Arasaka-Academy/CyberMachine/docs/images/r1/exploded.png

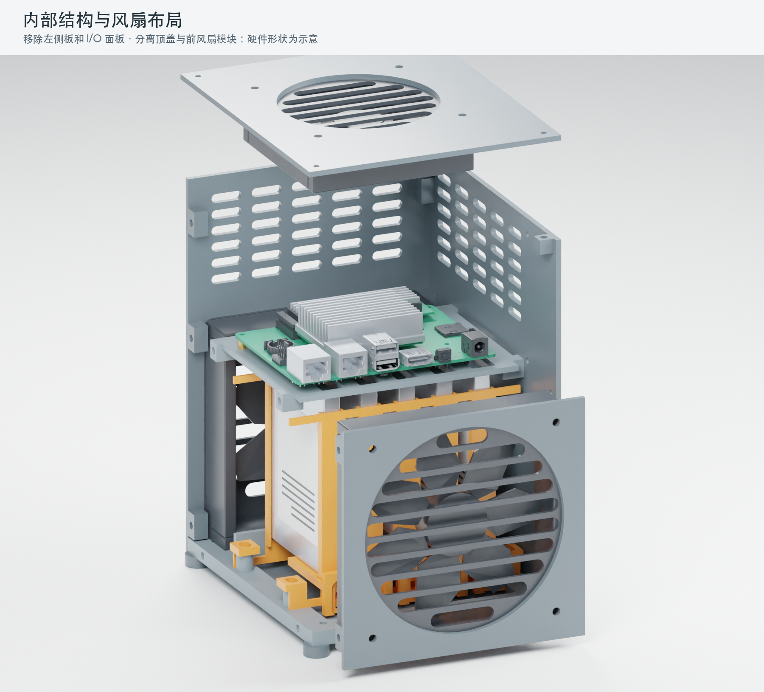
docs/images/r1/exploded.png
