Arasaka-Academy/CyberMachine/docs/images/r2/7mm-shims.png

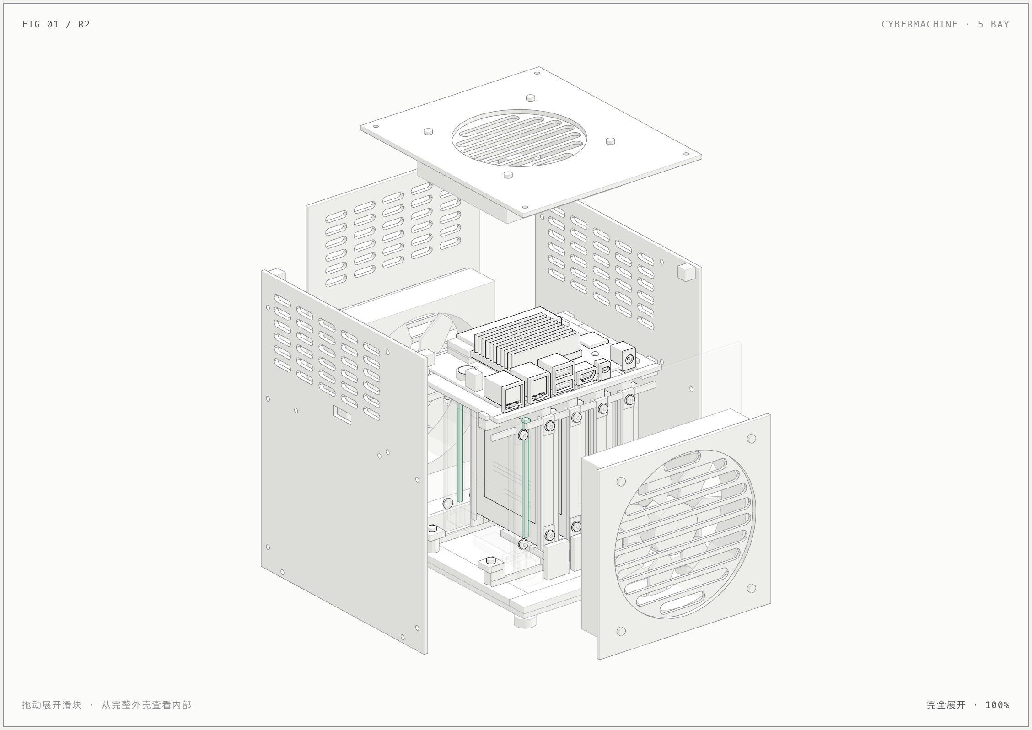
docs/images/r2/7mm-shims.png
