Arasaka-Academy/CyberMachine/hardware/enclosure/r1/cad/CyberMachine-r1-enclosure.step

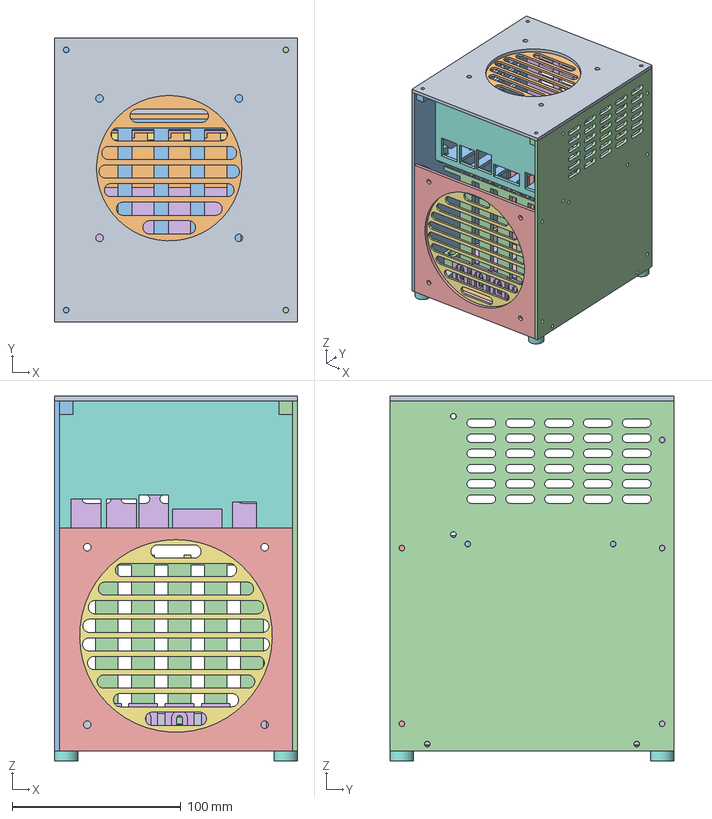
[picture p4: CAD file, 2026-11-03]
hardware/enclosure/r1/cad/CyberMachine-r1-enclosure.step
144.0 x 168.0 x 216.0 mm
