Arasaka-Academy/CyberMachine/hardware/enclosure/r1/print/CyberMachine-r1-fit-test-p1s.3mf

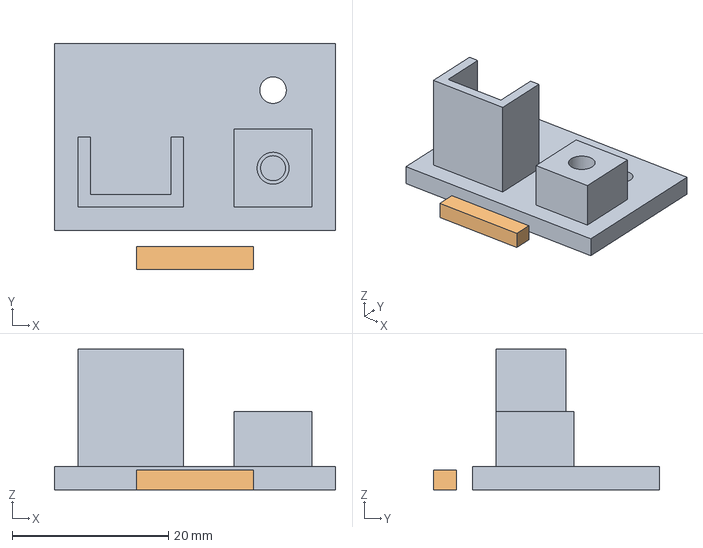
[picture p5: CAD file, 2026-11-03]
hardware/enclosure/r1/print/CyberMachine-r1-fit-test-p1s.3mf
36.0 x 29.0 x 18.0 mm
00_fit_coupon_1
00_fit_shim_2p5_1
