Arasaka-Academy/CyberMachine/references/radxa-taco/radxa_taco_3d_stp_v1.61.stp

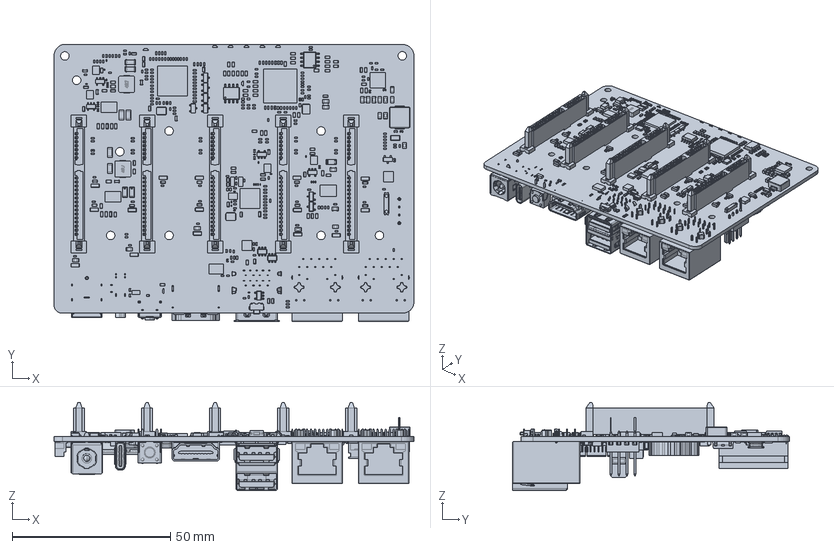
[picture p6: CAD file, 2026-11-03]
references/radxa-taco/radxa_taco_3d_stp_v1.61.stp
113.7 x 87.5 x 27.8 mm
TACO-V161_20250806
C0201 x 28
QFN76_9X9
R0402 x 203
C0402 x 174
C0805 x 38
C0603 x 70
C1206 x 9
R1206 x 3
SMD-LED-0603
LED0603 x 6
SOD523 x 2
R0805 x 7
L0603 x 21
WCM2012F x 3
0518_55X55 x 2
IND-6X6
IND-2520 x 4
IND-5020 x 4
IND_252012
SOT-23 x 5
SOT723 x 2
SOT23 x 4
R0201 x 24
R0603 x 57
T0_8
SOP8 x 3
SOT_23_5 x 4
8_LEAD_SOP x 2
SON10_2R50X1R00X0R50 x 6
EEPROM_TSSOP_8
MSOP_8 x 2
SCT2360 x 3
SLP2510P8 x 2
SOT23-8
QFN48_6X6
SOT23-6 x 2
TO252_H94
QFN_19P_20_157X157_2PAD
QFN_88P_16_394X394_PAD_ATH
CRY-D3225 x 3
CRY-MC146
SOIC8E
ESD0402 x 4
LED_MT-L1204RGBC-B3-SESESERB1
SMD-2P-1_25
SOD_123
SOT_23_5AA
SOT_323
AON7407
SW_4_DIP
TS_1100_5
APCI0164_4
APCI0108_200415_ASM_4
HDMI_1_2_4
LPJG0926HENL_4 x 2
DC-091-A200_1__4
MSBR-1_1_2_1_5_1_4
TF-CARD_1_2_1_5_1_4 x 2
LOWER_CONTACT_4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
