Arasaka-Academy/CyberMachine/hardware/enclosure/r1/print/CyberMachine-r1-5bay-p1s-petg.3mf

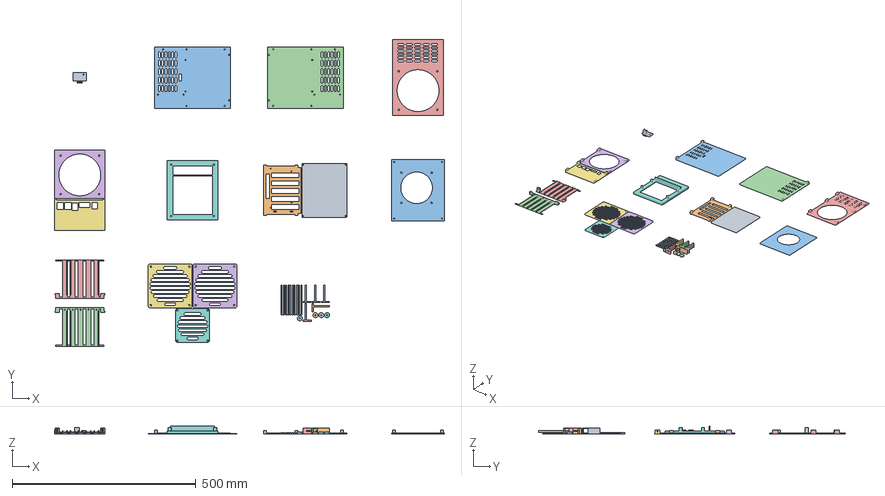
[picture p7: CAD file, 2026-11-03]
hardware/enclosure/r1/print/CyberMachine-r1-5bay-p1s-petg.3mf
1062.6 x 835.9 x 22.0 mm
00_fit_coupon_1
00_fit_shim_2p5_1
03_left_side_1
04_right_side_1
06_rear_fan_panel_1
05_front_fan_panel_1
09_recessed_IO_panel_1
01_base_frame_1
02_service_hatch_1
12_motherboard_saddle_1
10_top_lid_1
13_front_drive_guide_1
14_rear_drive_guide_1
07_front_guard_1
08_rear_guard_1
11_top_guard_1
15_drive_shoe_1_1
16_7mm_shim_1_front_1
16_7mm_shim_1_rear_1
15_drive_shoe_2_1
16_7mm_shim_2_front_1
16_7mm_shim_2_rear_1
15_drive_shoe_3_1
16_7mm_shim_3_front_1
16_7mm_shim_3_rear_1
15_drive_shoe_4_1
16_7mm_shim_4_front_1
16_7mm_shim_4_rear_1
15_drive_shoe_5_1
16_7mm_shim_5_front_1
16_7mm_shim_5_rear_1
17_foot_1_1
17_foot_2_1
17_foot_3_1
17_foot_4_1
