Arasaka-Academy/CyberMachine/docs/assembly/r1.md

# CyberMachine 五盘 NAS 外壳 · R1

CyberMachine NAS 设备的 R1 机箱设计，适配 Radxa Taco V1.61、5 块 2.5 英寸 SATA 硬盘（7 或 9.5 mm），前后 12025 风扇及顶部 9225 风扇。机箱主体 144 × 168 × 210 mm，脚垫另加 6 mm。原设计日期：2026-10-30。

## 先打印什么

先打开 **CyberMachine-r1-fit-test-p1s.3mf**，使用准备正式打印的 PETG 打印试装件。其 U 槽与正式导轨一致：净宽 10.3 mm；装入 2.5 mm 垫片后净宽为 7.8 mm。用实际硬盘边缘检查滑动配合，同时试装 M3 铜螺母和通孔。应能顺畅滑动，不能靠挤压硬盘来消除间隙。

确认后打开 **CyberMachine-r1-5bay-p1s-petg.3mf**，选择“作为项目打开”，保留项目配置。已配置 Bambu Lab P1S、0.4 mm 喷嘴、PETG、纹理 PEI 板、0.20 mm 层高、4 层壁、25% Gyroid 填充。五个独立托脚采用 100% 填充。通用 PETG 设定为喷嘴 255°C、热床 80°C；按实际耗材厂商建议调整温度后重新切片。

这是 Bambu Studio 多盘项目，包含切片结果。用 Bambu Studio 选择对应打印盘发送到 P1S；不要把整套装配 STEP 当作单个零件切片。

## 打印盘与零件

| 盘 | 内容 | 说明 |
|---|---|---|
| 01 | U 槽、2.5 mm 垫片和孔位试装件 | 先打印 |
| 02 / 03 | 左侧板 / 右侧板 | 外侧大平面朝下 |
| 04 | 后风扇面板 | 外侧朝下 |
| 05 | 前风扇面板、内缩 I/O 面板 | 大平面朝下 |
| 06 | 底框、导轨安装柱、后部挡风板 | 本盘已启用支撑；清除检修口台阶和挡风板下方的支撑 |
| 07 | 底部检修盖、主板支架 | 已设置打印方向 |
| 08 | 顶盖 | 平放 |
| 09 | 前后硬盘导轨 | 已设置方向并启用支撑；前导轨螺母座下方及主腹板底面的支撑需清除 |
| 10 | 两个 120 mm 护网、一个 92 mm 护网 | 平放 |
| 11 | 五个托脚、十条薄盘垫片、四个脚垫 | 9.5 mm 硬盘不用薄盘垫片，可在切片前取消相应对象 |

主项目共 11 盘、35 个打印对象，其中正式机箱 33 件、试装件 2 件。十条垫片供五块 7 mm 硬盘使用，每盘前后各一条；7/9.5 mm 可混装。

## 五金清单

| 五金 | 数量 | 位置 / 要求 |
|---|---:|---|
| M3 热熔铜螺母，外径 4.6 mm、长度 4 mm | 43 | 设计底孔 Ø4.1 × 4.8 mm；先用试装件确认热熔配合 |
| M3 × 8 螺丝 | 35 | 侧板 22、顶盖 4、检修盖 4、硬盘托脚 5；托脚螺丝头高 ≤1.7 mm，放入前耳凹槽 |
| M3 × 10 螺丝 | 8 | 导轨 4、机箱脚垫 4 |
| M3 大垫圈，内径约 3.2 mm、外径 14 mm | 4 | 导轨调节槽 |
| M3 垫圈，外径约 8–9 mm、厚 ≤0.5 mm | 5 | 托脚竖向调节槽；与薄圆头一同藏入凹槽，避免碰前风扇 |
| M2.5 双通圆柱隔离柱，长 6 mm、外径 4.5 mm | 4 | 支架与 Taco PCB 之间 |
| M2.5 × 6 螺丝 | 4 | 从支架下方固定隔离柱 |
| M2.5 × 4 螺丝 | 4 | PCB 上方拧入隔离柱；上下螺丝合计伸入量应小于柱长 |
| M4 × 35 螺丝 | 12 | 三个风扇，各四颗 |
| M4 薄螺母，厚约 2.2 mm | 12 | 风扇螺母；不要替换成更厚的尼龙锁紧螺母而仍使用同长度螺丝 |
| M4 垫圈，合计厚度每处不超过 1.3 mm | 24 | 每处约 0.8 + 0.5 mm；确认螺丝完全穿过薄螺母 |
| 薄橡胶 / TPU 小贴片 | 5，可选 | 贴在托脚接触面，计入高度调整 |
| 小扎带 | 2–4，可选 | 主板支架右侧设有穿带槽 |

铜螺母面应与塑料表面齐平。先热熔、冷却，再装电子部件。铜螺母、隔离柱及螺丝均不包含在 3MF 打印对象里。

## 装配顺序

1. **底框与导轨**：清除底框和前导轨支撑、毛刺。将前后导轨放在四个安装柱上，以 M3 × 10 和大垫圈轻轻预紧。前导轨带五个托脚安装螺母孔，朝机箱前方。调节槽留给整组盘位对准使用。
2. **框架**：以 M3 × 8 装左右侧板、后面板及 I/O 面板。前面板可先不装，方便操作托脚螺丝。
3. **主板支架**：先从支架下方用 M2.5 × 6 固定四根 6 mm 隔离柱，再用侧面四颗 M3 × 8 将支架固定到侧板。四个主板孔不是规则矩形，按实物及 STEP 对位。
4. **Taco 与散热件**：CM5/M.2 一面朝上，SATA 插座朝下。以 M2.5 × 4 固定 PCB。原有 CM5 官方被动散热器继续使用。顶扇下表面为 Z=180 mm，主板上表面 Z=135 mm；散热件最高点应不超过 Z=170 mm，保证至少 10 mm 气流空间。
5. **硬盘**：保持断电。9.5 mm 硬盘不装垫片；7 mm 硬盘将两条 2.5 mm 垫片放在相应导轨的正 X 一侧，即从机箱前方观察的右侧，端部小凸缘挂在导轨上端。每块硬盘沿导轨从下方向上插入，先手动对准 SATA，勿用壳体或螺丝把接口强行拉合。轻微移动整组导轨，找到五块硬盘都能自然插合的位置，再锁紧导轨四颗螺丝。
6. **独立托脚**：每个托脚前部用一颗 M3 × 8 和薄垫圈装到前导轨。螺丝头高不超过 1.7 mm、垫圈厚不超过 0.5 mm，装入前耳凹槽，保证不突出并留出前风扇间隙。沿竖槽调高低，使托脚刚好承托硬盘底端，然后锁紧。托脚承担硬盘重量，不能向上顶压 SATA 插座。以平台上表面 Z=22 mm 为初始位置，装底盖时可上调约 5 mm、下调约 1.5 mm；底盖不能顶住托脚的前耳。
7. **风扇**：前护网夹在前面板和风扇之间，风扇由前向内吹；后风扇从内向后排风；顶部护网夹在顶盖与 92 mm 风扇之间，顶扇向下吹。以风扇壳体的气流箭头确认方向。三处均为“3 mm 面板 + 2 mm 护网 + 25 mm 风扇”。
8. **收尾**：收好风扇线，使用支架扎带槽，留出拆顶盖的线缆余量。装顶盖、脚垫和底部检修盖。左侧小开口供 microSD 操作；电源 / BOOT 按钮通过拆顶盖操作。

顶部风扇为 **92 mm 方框 / 82.5 mm 孔距**。前后风扇为 **120 mm 方框 / 105 mm 孔距**。仅“厚 25 mm”不能代替上述框宽和孔距。

## 维护与风道

前进后出风道通过五块盘之间的空隙。底框后部挡风板减少从硬盘下方直接绕流；上舱从顶部送风，经 CM5/M.2 后由两侧及后部槽孔排出。

逐盘维护时断电并支稳机箱，拆底盖，托住对应硬盘，松开并取下其独立托脚，再将该盘向下拔出。托脚螺丝在前导轨朝前的一面；需要直线工具空间时，先拆下前风扇模块。上拔或下拔硬盘时用手承托，不能拉扯 PCB。

风扇供电、分线及调速控制器另备。模型仅提供安装和走线路径，没有验证 Taco 风扇接口同时带三只风扇的供电能力。

## 验证边界

已执行：原板 STEP 孔位 / 接口提取、原生 CAD 实体有效性检查、打印件之间的实体相交检查、与原板及风扇外框和散热包络的相交检查、7 / 9.5 mm 硬盘包络安装检查及连续向下 125 mm 的抽取路径检查、STL 封闭性及法向检查、P1S 全盘排版和 Bambu Studio 实际切片。抽取检查条件为已拆下底盖和托脚。

提供的 STEP 没有 CM5、散热马甲、实际硬盘、风扇或 M.2 SSD。原板使用精确模型；其余使用标明的外形包络。硬盘参考包络为 100.45 × 69.85 × 9.5 / 7 mm，导轨厚度基准及连接器端面采用通用 SATA 安装参考，保留整组约 ±1.3 mm（X）、±2.3 mm（Y）的调整量。实际硬盘连接器偏移和完全插入深度仍需用实物先行试装确认。

这是完成数字验证的 **R1 首版设计**，尚未在真实 P1S 上打印、装配或进行温升、噪声和振动测试。先打试装件，再试一块硬盘和一只风扇，确认后打印整套。渲染中的硬盘标签、风扇叶片和散热器为示意，不是另附的打印零件。

## 文件

- [CyberMachine-r1-5bay-p1s-petg.3mf](../../hardware/enclosure/r1/print/CyberMachine-r1-5bay-p1s-petg.3mf)：完整 P1S 多盘打印项目，含切片结果。
- [CyberMachine-r1-fit-test-p1s.3mf](../../hardware/enclosure/r1/print/CyberMachine-r1-fit-test-p1s.3mf)：独立试装项目。
- [CyberMachine-r1-enclosure.step](../../hardware/enclosure/r1/cad/CyberMachine-r1-enclosure.step)：按装配坐标保存的 33 个可编辑实体，保留分件名称；不含购买件。
- [CyberMachine-r1-stl.zip](../../hardware/enclosure/r1/print/CyberMachine-r1-stl.zip)：分件 STL 压缩包。
- [assembled.png](../images/r1/assembled.png) / [exploded.png](../images/r1/exploded.png)：装配与打开后的结构图。
- [report.json](../../validation/r1/report.json) / [plate-list.csv](../../hardware/enclosure/r1/print/plate-list.csv)：原交付的数字检查与切片统计。
- [design.py](../../hardware/enclosure/r1/src/design.py)：原生 CAD 构建脚本；[源码说明](../../hardware/enclosure/r1/src/README.md)包含重建方法。
