Arasaka-Academy/CyberMachine/docs/assembly/r2/notes/review-1.md

# 2026-11-06 · 第一轮检查

参考现有 R2 白灰结构图，检查五章真实浏览器截图、原厂 STEP 与装配路径。发现并修正：

- 主板入箱后镜头偏远，硬盘阶段下方工作支撑被裁切。按阶段设置近景与完整外观镜头，并按容器宽高比补偿手机视野。
- 待装支架和导轨在台面重叠。把待装支架移到独立区域；导轨、支架、隔离柱按台面高度放置。
- 无线卡倾斜时穿入插槽侧缘，I/O 面板碰到侧框上方安装块，检修盖穿过脚垫。缩窄补绘侧缘，I/O 从前下方斜向进入，检修盖先装、脚垫后装。
- 散热器示意底座与原厂 M-Key 外壳有 0.298 mm³ 细小重叠。底座后缘避让 0.2 mm，再次检查补绘主板组件。
- 盘位标记重叠，导致正确标记被相邻标记挡住。当前步骤仅显示对应盘位；错误插槽仍保留 E-Key / M-Key 对比。
- 早期天线线束经过散热器附近并伸出外壳。改为独立内置 FPC 天线，重新规划曲线，补充线径与避让采样。

精确采样、浏览器、影片与仓库检查分别保存在验证目录。数字结果不替代实物装配与射频测试。
