Arasaka-Academy/CyberMachine/docs/images/r1/assembled.png

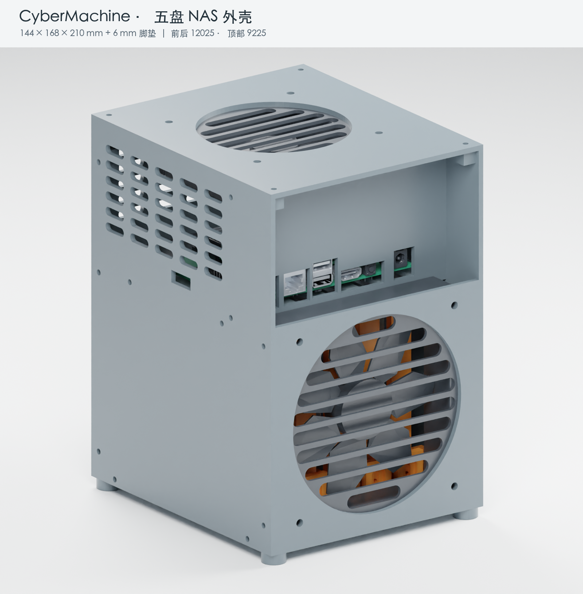
docs/images/r1/assembled.png
