Arasaka-Academy/CyberMachine/docs/images/r1/print-plates.png

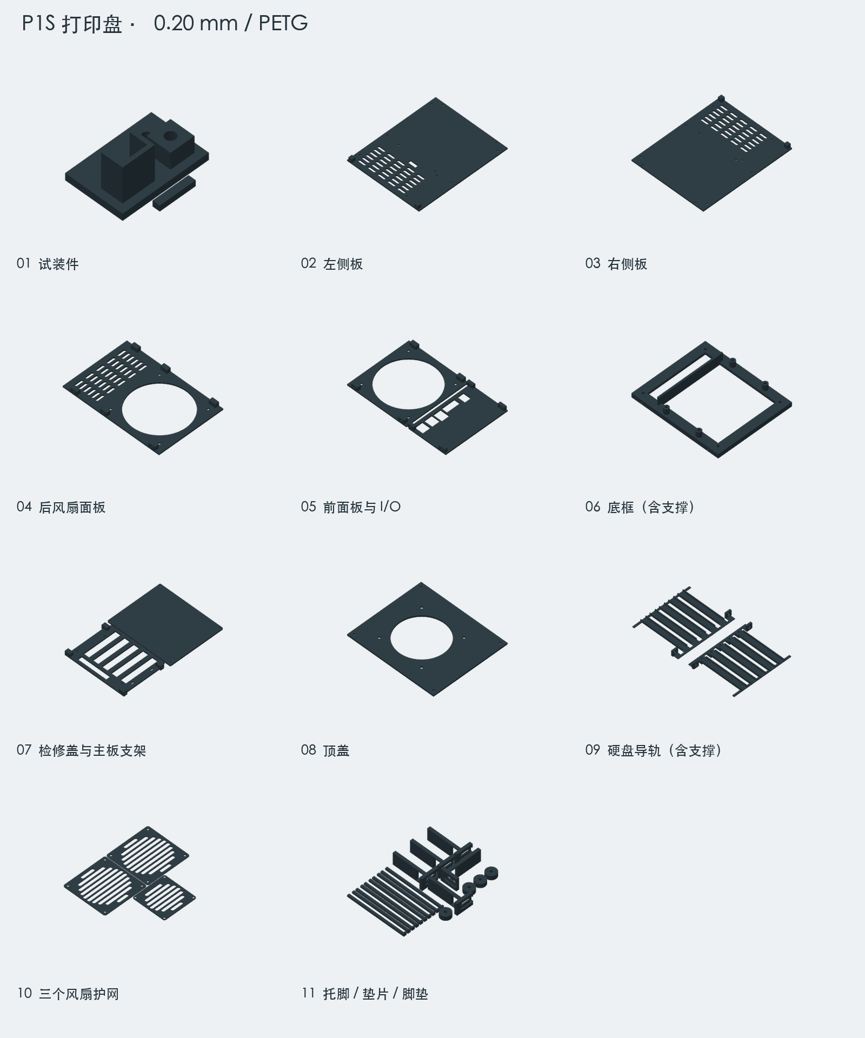
docs/images/r1/print-plates.png
