Arasaka-Academy/CyberMachine/docs/images/r2/assembled.png

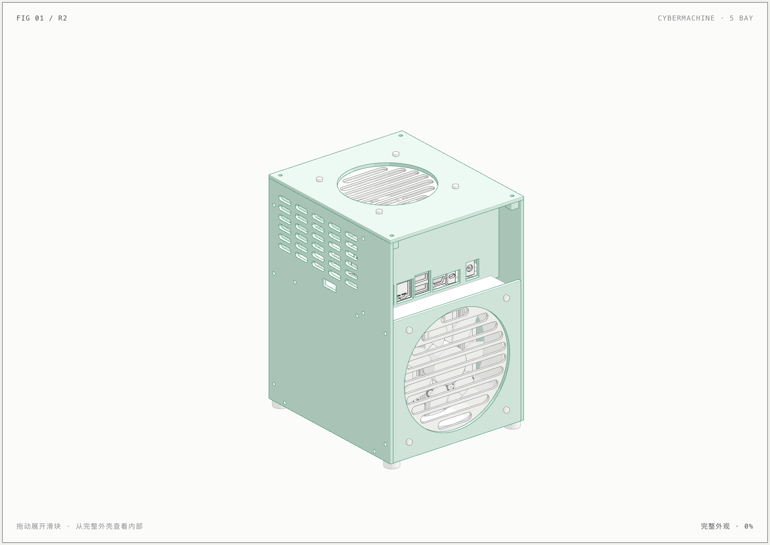
docs/images/r2/assembled.png
