Arasaka-Academy/CyberMachine/docs/images/r2/assembly-cm5.png

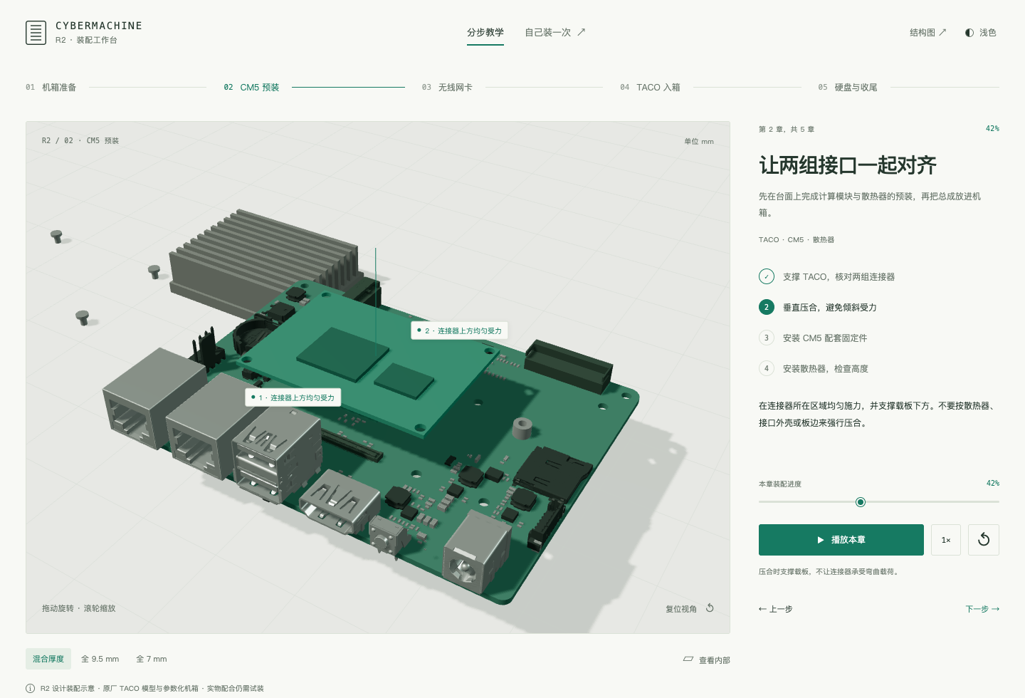
docs/images/r2/assembly-cm5.png
