Arasaka-Academy/CyberMachine/docs/images/r2/assembly-fasteners-rear.png

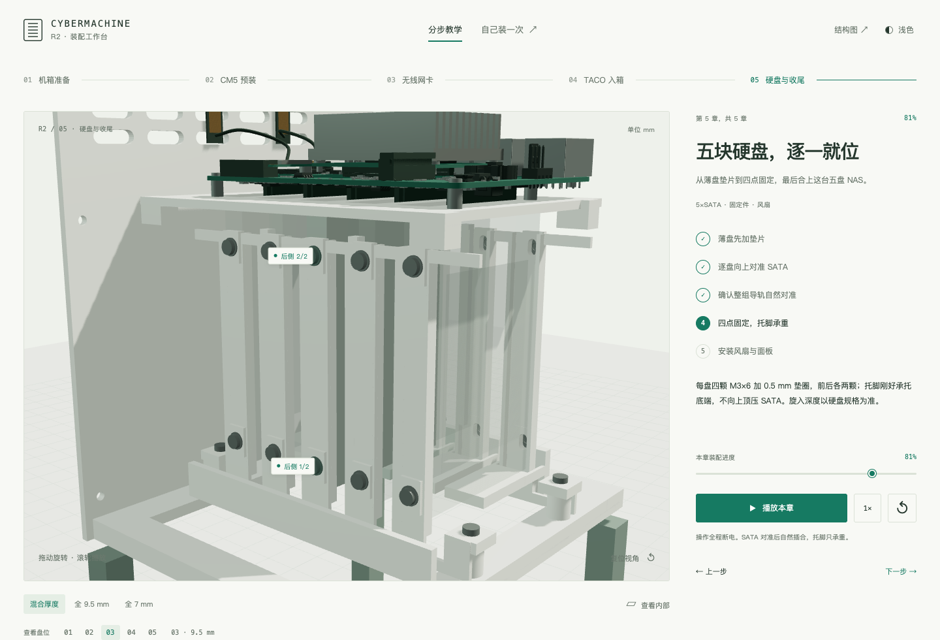
docs/images/r2/assembly-fasteners-rear.png
