Arasaka-Academy/CyberMachine/docs/images/r2/assembly-fasteners.png

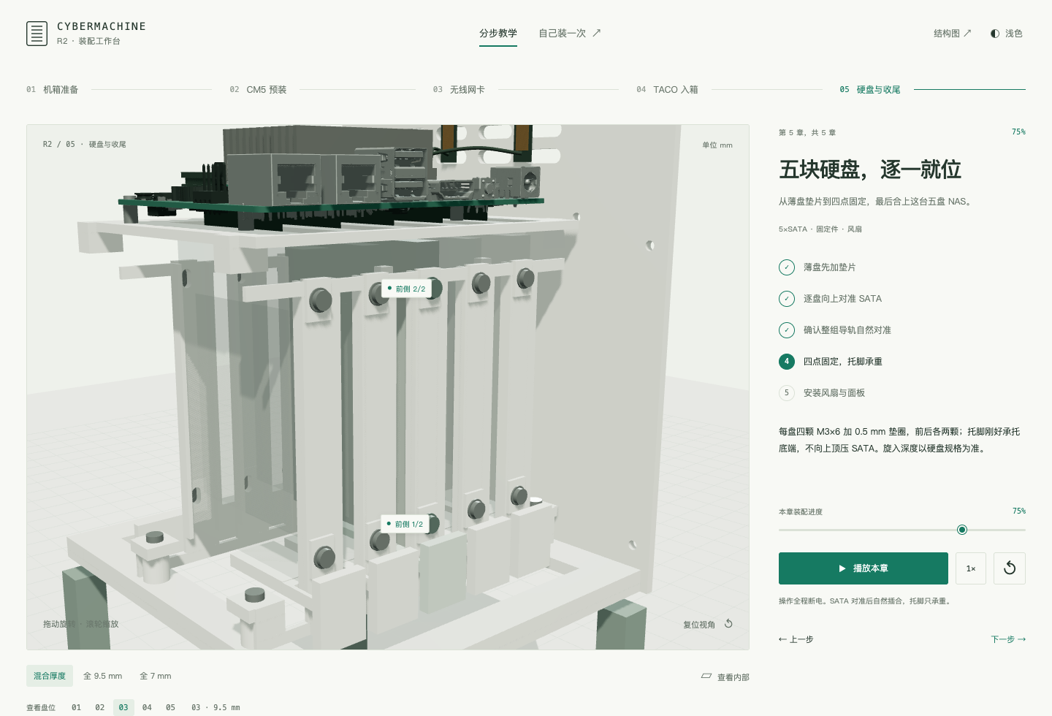
docs/images/r2/assembly-fasteners.png
