Arasaka-Academy/CyberMachine/docs/images/r2/assembly-finished.png

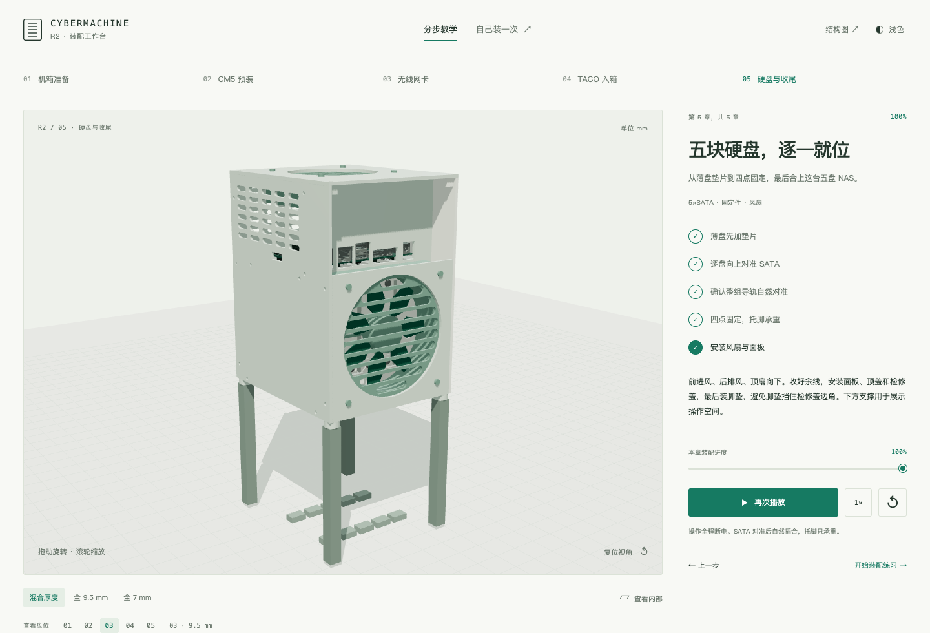
docs/images/r2/assembly-finished.png
