Arasaka-Academy/CyberMachine/docs/images/r2/assembly-frame.png

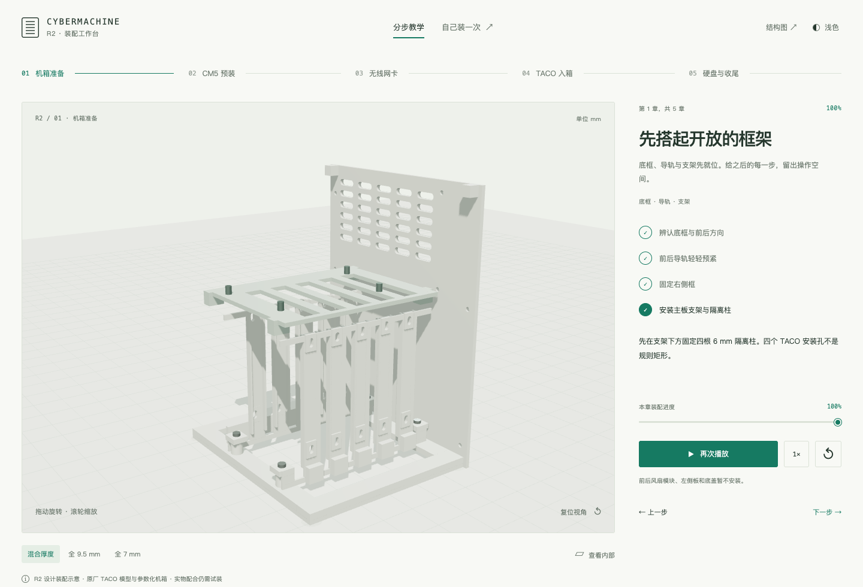
docs/images/r2/assembly-frame.png
