Arasaka-Academy/CyberMachine/docs/images/r2/assembly-mobile-practice.png

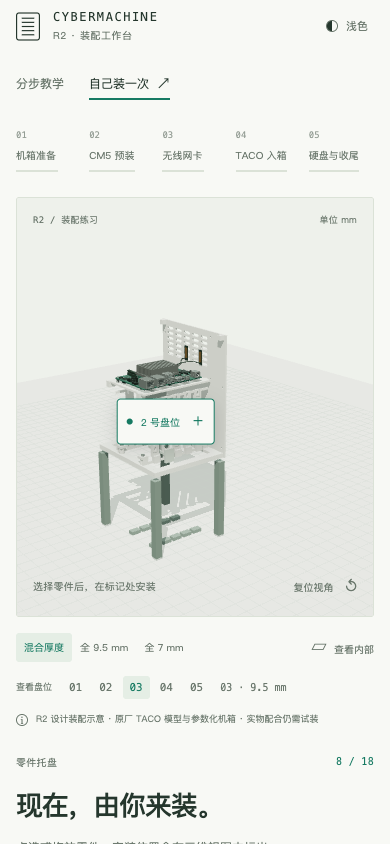
docs/images/r2/assembly-mobile-practice.png
