Arasaka-Academy/CyberMachine/docs/images/r2/assembly-mobile.png

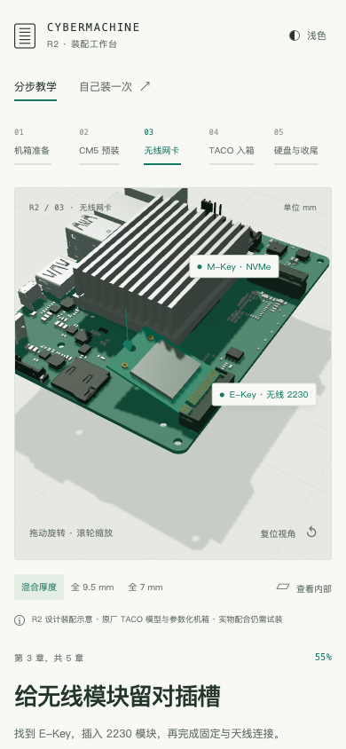
docs/images/r2/assembly-mobile.png
