Arasaka-Academy/CyberMachine/docs/images/r2/assembly-practice.png

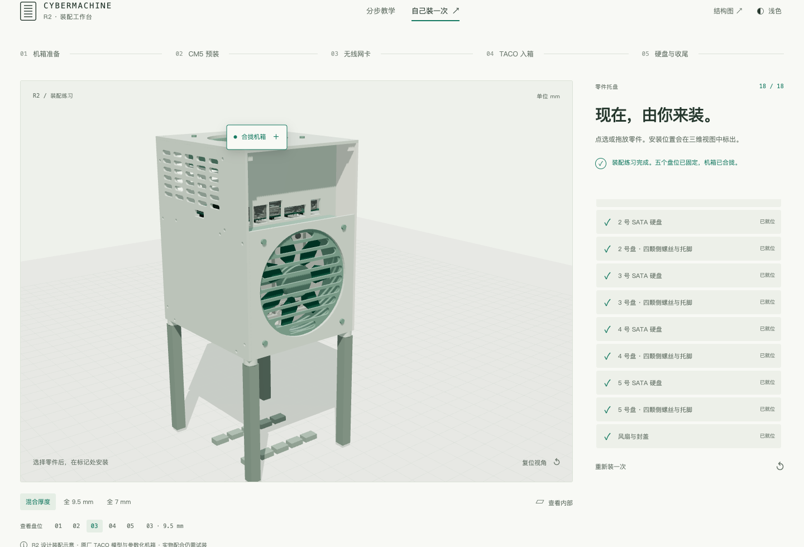
docs/images/r2/assembly-practice.png
