Arasaka-Academy/CyberMachine/docs/images/r2/assembly-taco.png

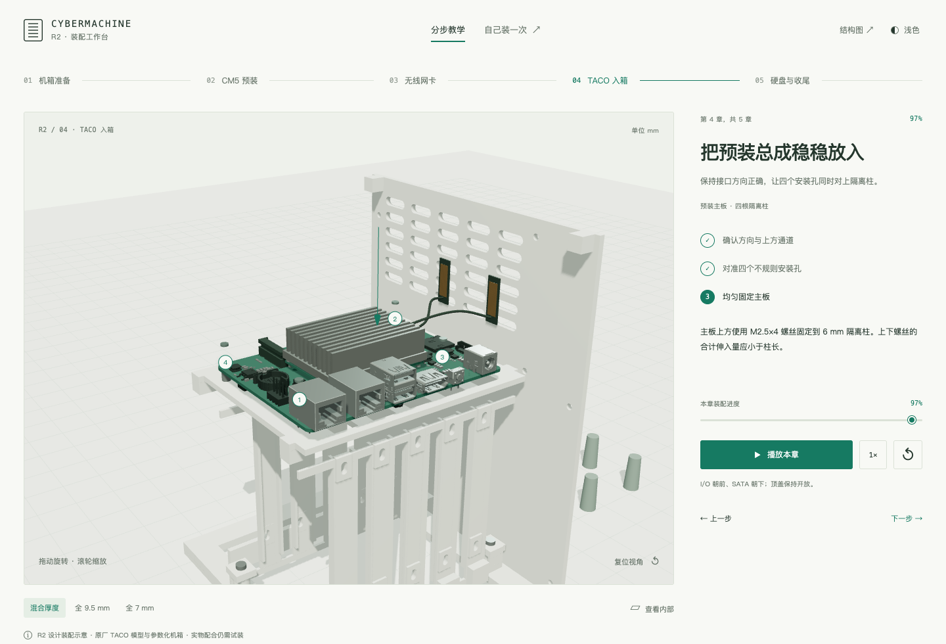
docs/images/r2/assembly-taco.png
