Arasaka-Academy/CyberMachine/docs/images/r2/assembly-wifi.png

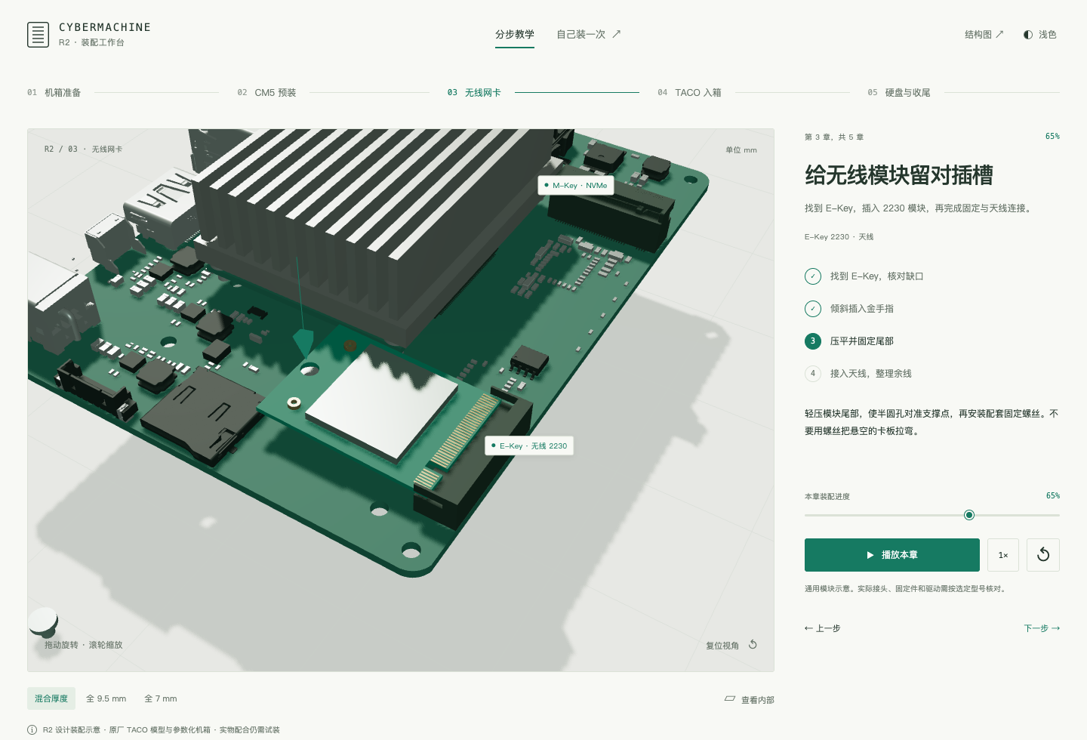
docs/images/r2/assembly-wifi.png
