Arasaka-Academy/CyberMachine/validation/r2/assembly-validation.md

# R2 三维装配教学 · 数字验证

日期：2026-11-06。对象：[离线教程](../../docs/assembly/r2/index.html)、[源码与复现说明](../../docs/assembly/r2/README.md)及 [30 秒操作预览](../../docs/assembly/r2/preview.mp4)。本报告针对 R2 装配设计教学，不改变 R1 制造资料的版本或验收状态。

## 模型与原始资料

- 使用仓库的 Radxa TACO V1.61 STEP，保留 730 个原厂实体；机箱沿用 R2 参数几何。新增教学组件使用 OCCT 8 生成有效实体，再经 Blender 3.6 导出网格。
- 模型含 55 个语义根节点、90 个网格、640,002 个三角形；54 组参数零件共 487 个有效几何体。源坐标为毫米，渲染统一映射为 `[x,z,-y]/1000`。
- 实际加载 GLB 后检查 SATA、CM5 和 E-Key 插接锚点，最大偏差约 0.0003 mm，满足小于 1 mm 的数字模型要求。补绘锚点的精度不代表已测量实物。
- 原厂 STEP 未包含 E-Key 连接器实体：依据 V1.61 位置图 U33 补绘；高度、通用网卡、散热器及天线部分尺寸是教学包络。没有下载外部模型，没有新增机壳天线孔。
- 模型、压缩副本、原始 STEP 的 SHA256 与网格统计见 [assembly-model.json](assembly-model.json)。

## 装配路径

[assembly-motion.json](assembly-motion.json)记录最新教学位姿的 OCCT 实体采样检查：五章、三种厚度共 1,515 个状态，每章采样 101 个进度，包含阶段边界。未发现相对最终装配接触基线新增的非预期穿透；新增板卡组件的 10 对最终实体组合均未检出体积重叠。

检查将原厂 SATA 插壳与硬盘插舌、CM5 两组板对板连接器的有意插合单独列出。继承的结构连接和螺丝接触以最终装配位置的接触体积作为基线，阈值为 0.05 mm³。报告保留源码哈希，可核对检查对应的动画版本。

天线两路曲线分别采样 10 种端子高度，每条曲线 201 个点，按 0.65 mm 半径扩展分段包围盒；20 条路径没有与所列主板、散热器、插槽、侧框及三风扇实体形成候选接触。该轮无需进入精确距离计算，不能据此报告一个实测最小净距。端子及 FPC 粘贴端的有意连接另行记录。

路径包含初始等待位置；检修盖先装、脚垫后装，I/O 面板沿前下方斜向进入。检查是离散采样，不是连续扫掠证明，也不模拟电缆柔性、手部或工具体积。

## 页面与练习

[assembly-browser.json](assembly-browser.json)记录 Chrome 156.0.8078.75 实测，1440 × 980 桌面与 390 × 844 触摸视口，12 项场景检查全部通过，另附锚点误差数据：

- 以 `file://` 打开并禁止网络请求，模型与界面正常显示；没有页面错误或网络资源依赖。
- 五章完整流程、任意进度跳转、上一步/下一步、回退、暂停、重播保持一致；盘位随逐盘演示同步，暂停不改变高亮和透明度，紧固件阶段保留手动选择的盘位。
- 浅色、深色、蓝图主题；混装、全 7 mm、全 9.5 mm；五盘选择、查看内部、自由旋转、复位视角和实体选择。
- 键盘操作，桌面真实拖放、移动端触摸点选；390px 没有横向溢出。
- 错误 M-Key、缺本盘垫片、缺侧螺丝和过早封盖均提示原因并保留练习进度；三种厚度均能完成正确装配。切换厚度后重置硬盘相关进度。
- 视图离屏暂停、返回后连续恢复；减少动态效果时直接显示章末状态，重播也不产生动画。
- 页面隐藏的测试覆盖 `visibilitychange` 事件与时钟契约；因无头浏览器后台页行为不稳定，测试覆盖了 `document.hidden`，不声称验证操作系统最小化或休眠行为。
- 页面中的文档、视频和模型链接均解析到本地文件。

检查机器为 Apple M1 Max，ANGLE Metal 渲染，采样约 60 FPS；这不是所有设备的性能保证。另有 7 项逻辑测试通过，覆盖不同厚度的前置条件、错误操作不变性、重复安装、确定性跳步、播放与暂停的显示一致性和最终锚点。

章节关键镜头：[框架](../../docs/images/r2/assembly-frame.png)、[CM5 受力位置](../../docs/images/r2/assembly-cm5.png)、[E-Key / M-Key](../../docs/images/r2/assembly-wifi.png)、[TACO 四孔](../../docs/images/r2/assembly-taco.png)、[前侧紧固件](../../docs/images/r2/assembly-fasteners.png)、[后侧紧固件](../../docs/images/r2/assembly-fasteners-rear.png)、[封盖](../../docs/images/r2/assembly-finished.png)、[练习](../../docs/images/r2/assembly-practice.png)、[手机](../../docs/images/r2/assembly-mobile.png)、[手机练习](../../docs/images/r2/assembly-mobile-practice.png)。

## 操作预览

[assembly-film.json](assembly-film.json)记录离线页面的真实按钮、4 倍播放、旋转和练习操作；画面由虚拟 RAF / performance / Date 时钟驱动，不直接改场景位姿。视频为 30.000 秒、900 帧、960 × 600、30 FPS、H.264 / yuv420p，无声。

正式视频生成后重新生成并人工查看接触表和关键帧，CM5、无线槽、四孔、固定件、封盖和错误提示可辨认。`frame-guard` 未报告当前对象取景错误；`mpdecimate` 保留 887 帧，最大保留帧间隔约 0.133 秒。视频、HTML 的哈希与操作记录保存在报告中；原始帧和接触表留在忽略的工作目录。

## 仓库检查

- 已实际执行 `node docs/anatomy/r2/src/build.mjs --audit`，三种厚度全部通过。每种模式为 61 个深度状态、61 个净空状态、0.25 px 遮挡采样精度；分别见 [混装](audit-mixed.json)、[全 9.5 mm](audit-9.5.json)、[全 7 mm](audit-7.json)。这是结构图的数字审计，与上述三维装配路径检查分别记录。
- 已从仓库根目录重建结构图深浅两套 HTML / SVG，并从其他工作目录用绝对脚本路径重建两套页面。
- 教程使用 Node.js 22.22.0 与锁定的 Vite 依赖构建；从其他工作目录再次构建，HTML 和许可证文本的 SHA256 完全一致。JSX 经过 Vite 生产编译。
- 结构图深浅两页均离线复查厚度、组件、盘位、键盘、主题、减少动态效果和 390px 布局，点击新增入口可打开完整教程；没有页面错误或网络资源依赖，见 [结构图浏览器记录](assembly-anatomy-browser.json)。
- Python / JavaScript 语法、JSON / SVG 解析、Markdown / HTML 本地链接和图片路径检查通过。公开文件暂存验证通过，临时工作数据与依赖目录未进入交付清单。
- 19 份原有 R1 和原厂参考资料与本次工作开始前的 Git 版本逐字节一致。根目录 [SHA256SUMS.txt](../../SHA256SUMS.txt)已在正式文件生成后重新生成，并逐项校验通过。

## 验证边界

没有进行 R2 实物打印、试装、螺丝深度核对、温升、振动、噪声、风量、电气供电、具体网卡驱动或射频测试。天线只演示连接与避让走线。螺纹、手部和工具不在模型中；不得用本教程替代元器件说明书或将其网格作为制造数据。
