Arasaka-Academy/CyberMachine/(commit log)

2026-11-03 feat: initialize CyberMachine NAS hardware design repository
    [CyberMachine-r1-5bay-p1s-petg.3mf, CyberMachine-r1-enclosure.step, CyberMachine-r1-fit-test-p1s.3mf, plate-list.csv, radxa_taco_3d_stp_v1.61.stp]
2026-11-03 fix(anatomy): align NAS illustrations with CAD and vendor geometry
    Restore the complete enclosure and match the Taco PCB, SATA sockets and I/O
    positions to the supplied STEP. Correct handedness, fan guards, aperture
    reveals and saddle joins, then regenerate both themes and all previews.
    Record 12 native-envelope comparisons and zero-failure full precision audits
    across 61 poses in each thickness mode, along with offline desktop, mobile,
    keyboard and motion checks. Preserve R1 manufacturing files and document
    remaining schematic and physical-validation limits.
2026-11-06 feat(assembly): teach and publish the R2 assembly sequence
    Add source-derived 3D lessons and assembly practice for the chassis,
    CM5, E-Key Wi-Fi, TACO carrier and five SATA bays, with offline assets
    and a 30-second interaction preview.
    Publish the lesson through the existing Pages workflow and expose it
    from the anatomy figure and repository documentation. Keep R2 design
    validation separate from R1 manufacturing and physical acceptance.
    Validation: 7 logic tests, 12 offline browser scenarios, 1515 sampled
    assembly poses, three complete anatomy audits and repository checksums.
